Ross0907/Wonkle/README.md

# Wonkle

WBP logo



Wonkle builds gaming hardware such as tablets and keypads for gamers.
Source code, 3D models, schematics, etc. are available under
[OSI-Approved Software and Hardware Licenses](https://opensource.org/licenses). We welcome everyone
to contribute and join us in our quest to make the best hardware for our fellow gamers.

## [Frequently Asked Questions](https://docs.wonkle.io/faq.html)

## Star History

Star History Chart (https://www.star-history.com/#wonkleio/wonkle&type=date&legend=top-left)

## Contributors

Wonkle is built by people like you.

profile pictures of contributors (https://github.com/wonkleio/wonkle/graphs/contributors)
