Ross0907/Wonkle/docs/README.md

# Wonkle docs

## Must read

- https://vitepress.dev

## Setup

1. Setup development environment with [mise](https://mise.jdx.dev/getting-started.html) and [nix](https://nix.dev/install-nix.html)
   - [IDE integration](https://mise.jdx.dev/ide-integration.html)
2. Install dependencies:
   ```bash
   bun install
   ```
3. Start dev server:
   ```bash
   bun dev
   ```
4. (Optional) Install railpack
   ```
   mise use --global github:railwayapp/railpack@latest
   ```
5. (Optional) Test build locally
   ```
   railpack build .
   ```
