Ross0907/Wonkle/pcb/board/pro/pompyboard.kicad_sch

## KiCad design pcb/board/pro/pompyboard.kicad_sch (2026-02-09)

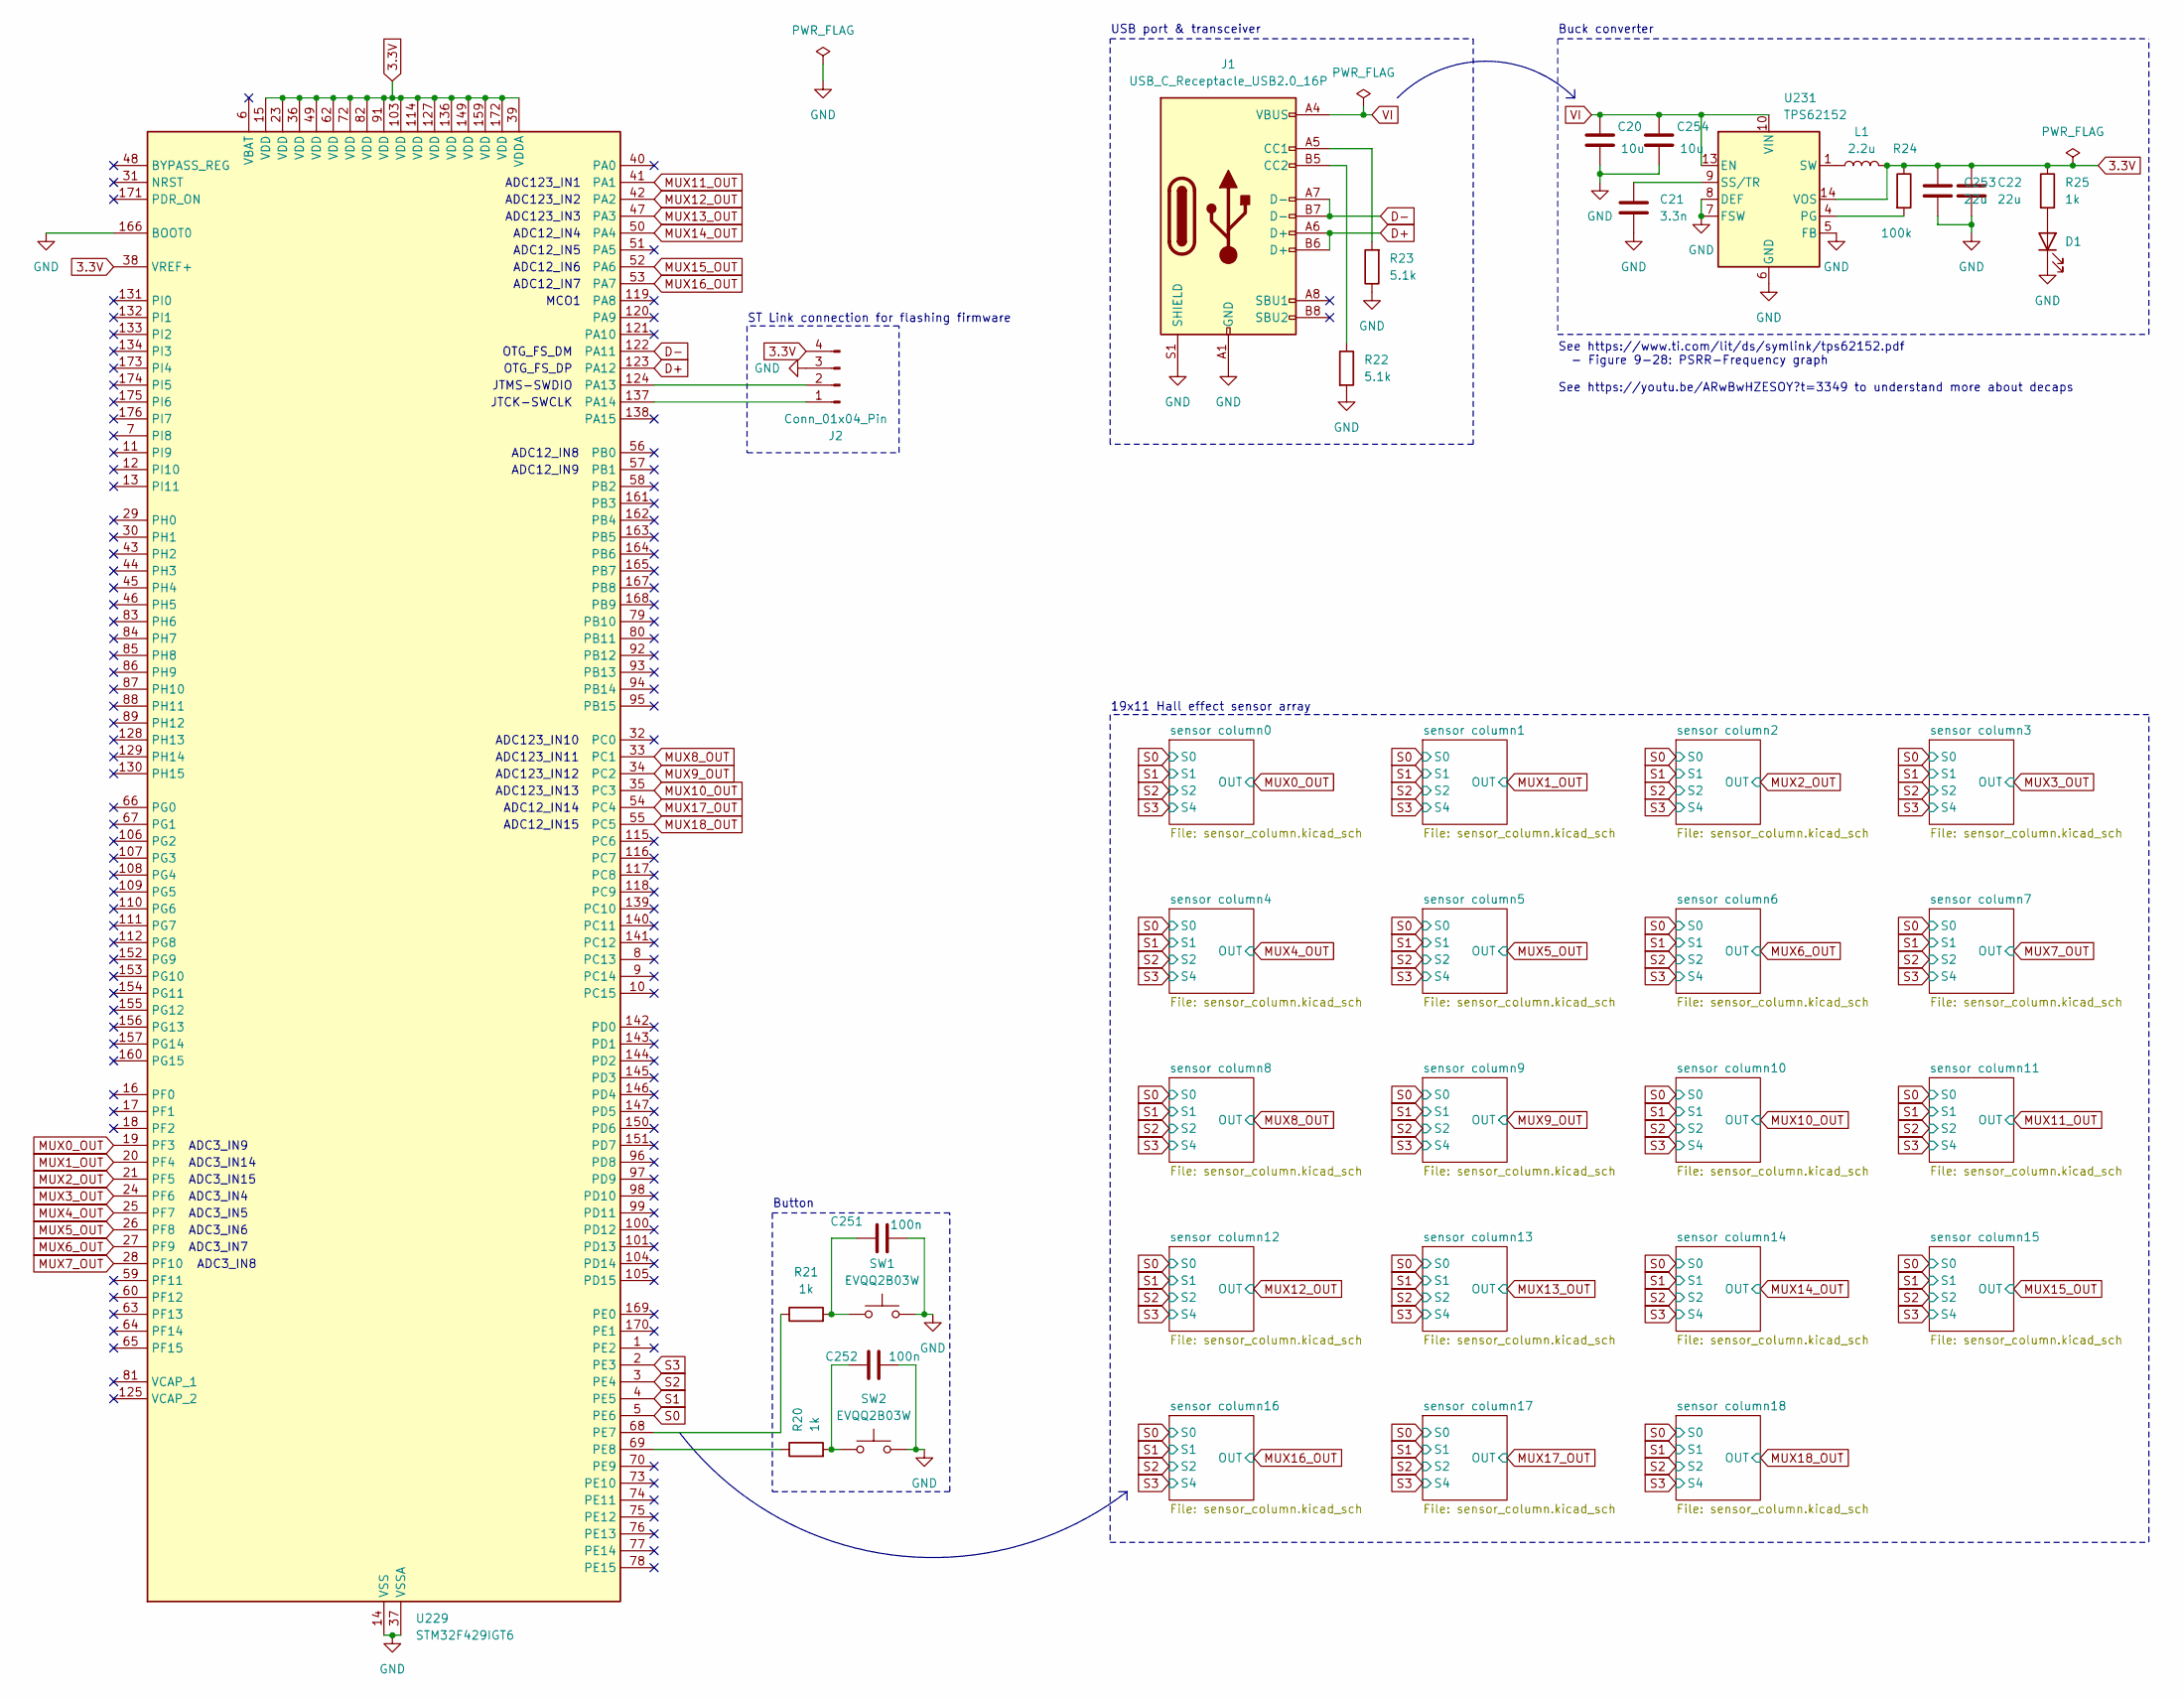
[picture p1: schematic pompyboard.kicad_sch]

Parts:
C20, C254: 10u; C_0402_1005Metric; LCSC Part # C315248
C21: 3.3n; C_0402_1005Metric; LCSC Part # C3881585
C22, C253: 22u; C_0402_1005Metric; LCSC Part # C105226
C251, C252: 100n; C_0402_1005Metric; LCSC Part # C1525
D1: F.0603.00139/P2-0603R1TS2-06T-002; LED_0603_1608Metric; LCSC Part # C7496820
J1: USB_C_Receptacle_USB2.0_16P; USB_C_Receptacle_GCT_USB4085; LCSC Part # C7095263
J2: Conn_01x04_Pin; PinHeader_1x04_P2.54mm_Horizontal; LCSC Part # C32713263
L1: 2.2u; L_Coilcraft_XxL4020; LCSC Part # C122469
R20, R21: 1k; R_0402_1005Metric; LCSC Part # C25744
R22, R23: 5.1k; R_0402_1005Metric; LCSC Part # C25905
R24: 100k; R_0603_1608Metric; LCSC Part # C22369815
R25: 1k; R_0402_1005Metric; LCSC Part # C11702
SW1, SW2: EVQQ2B03W; SW_SPST_EVQQ2; LCSC Part # C79178
U229: STM32F429IGT6; LQFP-176_24x24mm_P0.5mm
U231: TPS62152; VQFN-16-1EP_3x3mm_P0.5mm_EP1.68x1.68mm_ThermalVias; LCSC Part # C2070611

Connections:
3.3V: C22.1, C253.1, J2.4, L1.2, R24.1, R25.1, U229.15 (VDD), U229.23 (VDD), U229.36 (VDD), U229.38 (VREF+), U229.39 (VDDA), U229.49 (VDD), U229.62 (VDD), U229.72 (VDD), U229.82 (VDD), U229.91 (VDD), U229.103 (VDD), U229.114 (VDD), U229.127 (VDD), U229.136 (VDD), U229.149 (VDD), U229.159 (VDD), U229.172 (VDD), U231.14 (VOS)
D+: J1.A6 (D+), J1.B6 (D+), U229.123 (PA12)
D-: J1.A7 (D-), J1.B7 (D-), U229.122 (PA11)
GND: C20.2, C21.2, C22.2, C251.2, C252.2, C253.2, C254.2, D1.1 (K), J1.A1 (GND), J1.A12 (GND), J1.B1 (GND), J1.B12 (GND), J1.S1 (SHIELD), J2.3, R22.2, R23.1, SW1.2, SW2.2, U229.14 (VSS), U229.22 (VSS), U229.37 (VSSA), U229.61 (VSS), U229.71 (VSS), U229.90 (VSS), U229.102 (VSS), U229.113 (VSS), U229.126 (VSS), U229.135 (VSS), U229.148 (VSS), U229.158 (VSS), U229.166 (BOOT0), U231.5 (FB), U231.6 (GND), U231.7 (FSW), U231.8 (DEF), U231.15 (GND), U231.16 (GND), U231.17 (GND)
MUX0_OUT: U229.19 (PF3)
MUX1_OUT: U229.20 (PF4)
MUX2_OUT: U229.21 (PF5)
MUX3_OUT: U229.24 (PF6)
MUX4_OUT: U229.25 (PF7)
MUX5_OUT: U229.26 (PF8)
MUX6_OUT: U229.27 (PF9)
MUX7_OUT: U229.28 (PF10)
MUX8_OUT: U229.33 (PC1)
MUX9_OUT: U229.34 (PC2)
MUX10_OUT: U229.35 (PC3)
MUX11_OUT: U229.41 (PA1)
MUX12_OUT: U229.42 (PA2)
MUX13_OUT: U229.47 (PA3)
MUX14_OUT: U229.50 (PA4)
MUX15_OUT: U229.52 (PA6)
MUX16_OUT: U229.53 (PA7)
MUX17_OUT: U229.54 (PC4)
MUX18_OUT: U229.55 (PC5)
unnamed: C21.1, U231.9 (SS/TR)
unnamed: C251.1, R21.2, SW1.1
unnamed: C252.1, R20.2, SW2.1
unnamed: D1.2 (A), R25.2
unnamed: J1.A5 (CC1), R23.2
unnamed: J1.B5 (CC2), R22.1
unnamed: J2.1, U229.137 (PA14)
unnamed: J2.2, U229.124 (PA13)
unnamed: L1.1, U231.1 (SW), U231.2 (SW), U231.3 (SW)
unnamed: R20.1, U229.69 (PE8)
unnamed: R21.1, U229.68 (PE7)
unnamed: R24.2, U231.4 (PG)
S0: U229.5 (PE6)
S1: U229.4 (PE5)
S2: U229.3 (PE4)
S3: U229.2 (PE3)
VI: C20.1, C254.1, J1.A4 (VBUS), J1.A9 (VBUS), J1.B4 (VBUS), J1.B9 (VBUS), U231.10 (VIN), U231.11 (VIN), U231.12 (VIN), U231.13 (EN)

Notes on the sheet:
ADC3_IN6
ADC3_IN8
ADC12_IN15
ADC3_IN14
ADC12_IN14
ADC123_IN10
ADC123_IN12
Button
ADC12_IN9
ADC3_IN15
OTG_FS_DM
ADC3_IN4
See https://www.ti.com/lit/ds/symlink/tps62152.pdf - Figure 9-28: PSRR-Frequency graph See https://youtu.be/ARwBwHZESOY?t=3349 to understand more about decaps
ADC12_IN4
Buck converter
19x11 Hall effect sensor array
ADC3_IN9
ADC123_IN1
ADC123_IN13
ADC12_IN6
ADC3_IN5
ADC12_IN5
ST Link connection for flashing firmware
JTCK-SWCLK
USB port & transceiver
OTG_FS_DP
MCO1
ADC123_IN11
ADC12_IN8
ADC12_IN7
JTMS-SWDIO
ADC123_IN3
ADC123_IN2
ADC3_IN7
