Ross0907/Wonkle/pcb/board/pro/sensor.kicad_sch

## KiCad design pcb/board/pro/sensor.kicad_sch (2026-02-09)

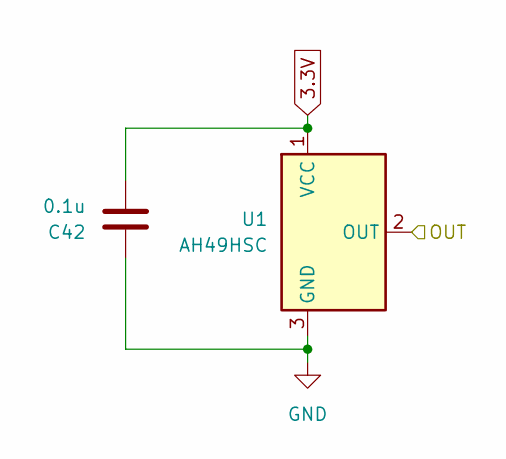
[picture p2: schematic sensor.kicad_sch]

Parts:
C42: 0.1u; C_0402_1005Metric; LCSC Part # C1525
U1: AH49HSC; SOT-23-3; LCSC Part # C510723

Connections:
3.3V: C42.2, U1.1 (VCC)
GND: C42.1, U1.3 (GND)
OUT: U1.2 (OUT)
