Ross0907/Wonkle/pcb/board/pro/sensor_column.kicad_sch

## KiCad design pcb/board/pro/sensor_column.kicad_sch (2026-02-09)

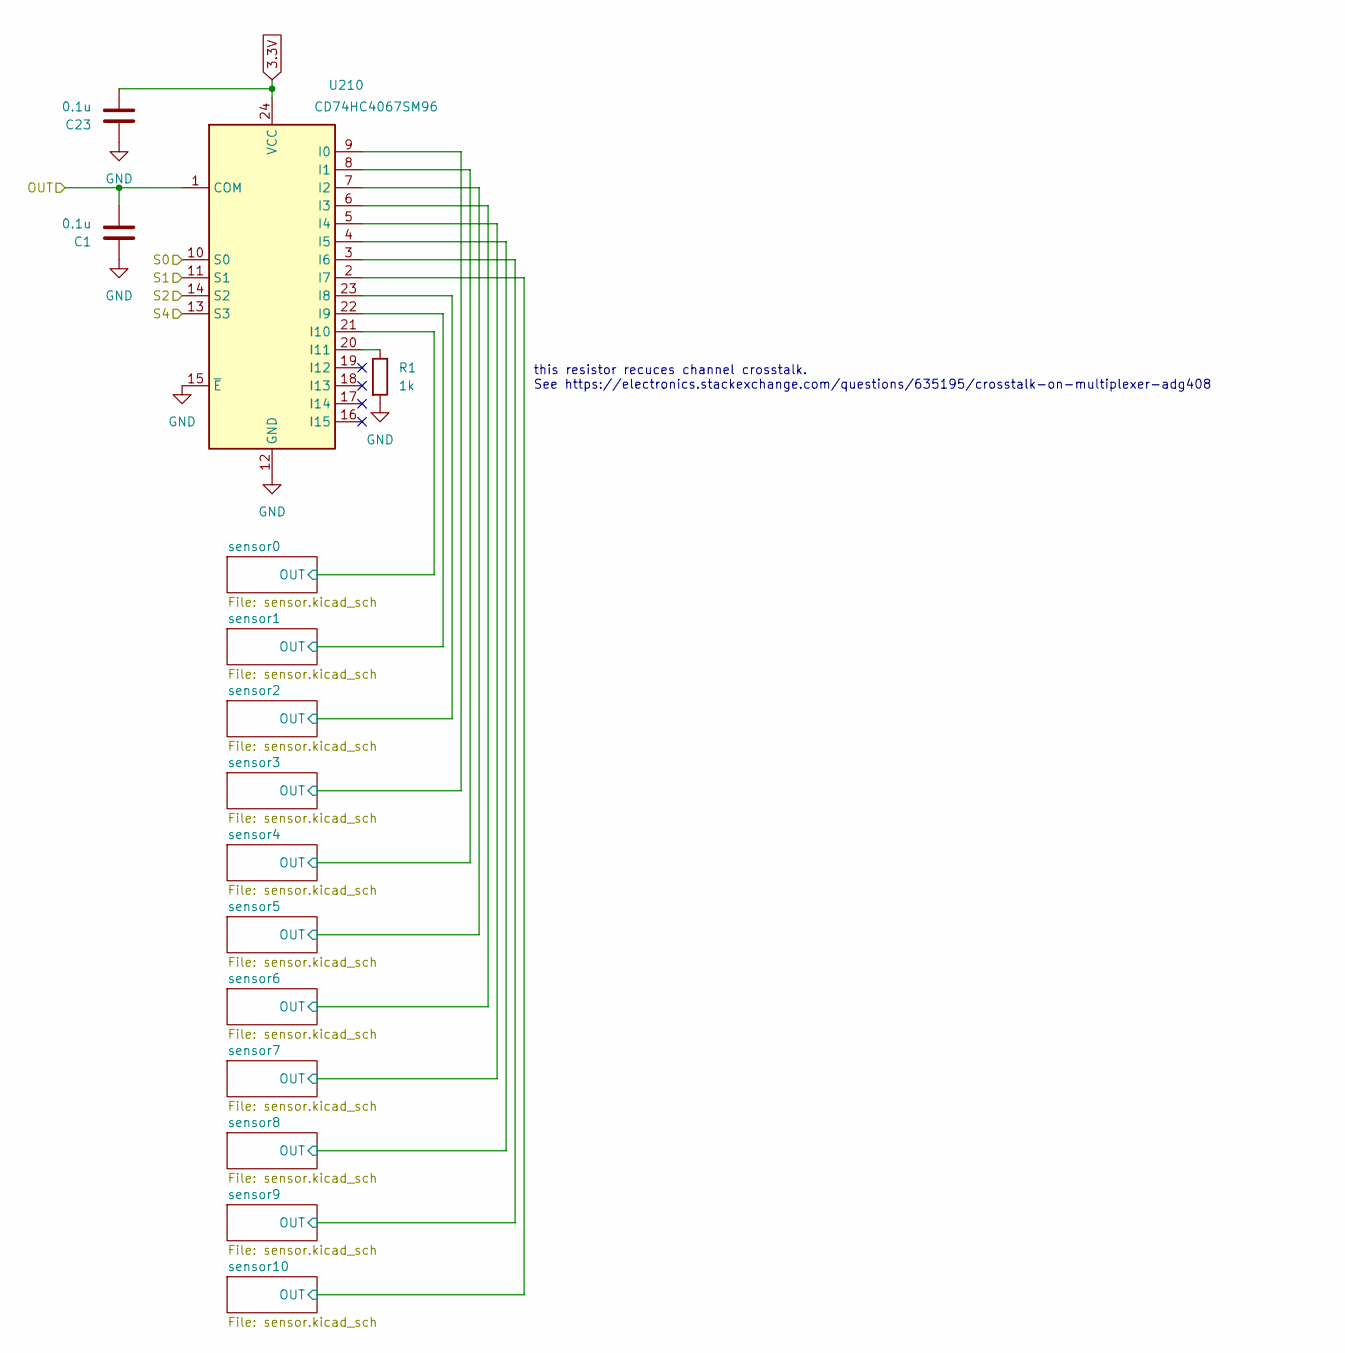
[picture p3: schematic sensor_column.kicad_sch]

Parts:
C1, C23: 0.1u; C_0402_1005Metric; LCSC Part # C1525
R1: 1k; R_0402_1005Metric; LCSC Part # C11702
U210: CD74HC4067SM96; SSOP-24_5.3x8.2mm_P0.65mm

Connections:
3.3V: C23.2, U210.24 (VCC)
GND: C1.1, C23.1, R1.2, U210.12 (GND), U210.15 (~E)
unnamed: R1.1, U210.20 (I11)
OUT: C1.2, U210.1 (COM), U210.2 (I7), U210.3 (I6), U210.4 (I5), U210.5 (I4), U210.6 (I3), U210.7 (I2), U210.8 (I1), U210.9 (I0), U210.21 (I10), U210.22 (I9), U210.23 (I8)
S0: U210.10 (S0)
S1: U210.11 (S1)
S2: U210.14 (S2)
S4: U210.13 (S3)

Notes on the sheet:
this resistor recuces channel crosstalk. See https://electronics.stackexchange.com/questions/635195/crosstalk-on-multiplexer-adg408
