Ross0907/Wonkle/FAQ.md

<h1 align="center"> >>> <a href="https://docs.wonkle.io/faq.html" target="_blank" >docs.wonkle.io</a> <<< </h1>
<h1 align="center"> >>> <a href="https://docs.wonkle.io/faq.html" target="_blank" >docs.wonkle.io</a> <<< </h1>
<h1 align="center"> >>> <a href="https://docs.wonkle.io/faq.html" target="_blank" >docs.wonkle.io</a> <<< </h1>
