Ross0907/Wonkle/(commit log)

2025-11-02 Shop pages (#5)
    * made a better landing page and updated next.js to 16.0.0 react 19.2.0 and react dom 19.2.0
    * style: update button and footer styles to match Discord branding
    - Changed the "Join our Discord" button background to Discord's blue and adjusted hover effects.
    - Updated footer Discord link styles to use Discord's blue on hover.
    - Modified Open Collective link hover color to a lighter shade of blue.
    - Adjusted email link hover color to a new shade of purple and updated the icon.
    - Improved navbar community link with an icon and adjusted styles for better alignment.
    - Reduced auto-rotate speed in shop item component for smoother experience.
    should also be better now also started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
2025-11-04 make "All products" look and feel better (#8)
    * web: make "All products" button actually bring users to product list
    * web: make spacing look better on "All products" button
    * web: add aria-label for accessibility
2025-11-09 web: make eslint track deprecated APIs (#26)
2025-11-09 rebrand (#27)
    * remove BRANDING.md (will be replaced with branding page on the website)
    * remove comparison that's already in the website
    * rebrand from Pompyboard to Wonkle
    [usb.rs]
2025-11-20 organize pcb files for future products
    [pompyboard.kicad_sch, sensor.kicad_sch, sensor_column.kicad_sch]
2025-11-22 web: add wonkle pronunciation button (#29)
    * web: added wonkle text with pronunciation button
    * web: consistent icon, button and footer refactored
    * web: removed unnecessary footer files
    * web: type removed from button
    * web: correct formatting
    * web: update wonkle pronunciation audio file
    * fix pronunciation button making unnecessary network requests
    * fix rebase fuckery
    ---------
2025-11-25 increase prettier printWidth from 80 to 100 to match oxfmt
2025-11-26 web: add accessible name to pronunciation button
2025-12-03 add sponsor button to github repo
2026-02-09 Updated with filter caps
    [pompyboard.kicad_sch, sensor.kicad_sch, sensor_column.kicad_sch]
2026-02-10 Renamed PCB silkscreen to Wonkleboard Pro mk.1
2026-02-10 pcb(wonkleboard pro): Update PCB with Filtering Caps (2 layer ver) (#33)
    [pompyboard.kicad_sch, sensor.kicad_sch, sensor_column.kicad_sch]
2026-02-10 fix ground pour and minor cleanup
2026-02-10 Minor Ground Pour FIx (#34)
